klangmodulator/a130-8-expander/README.md

# a130-8-expander
Expander for the Doepfer A130-8 octal linear VCA eurorack module.
Link to Modwiggler thread: [https://modwiggler.com/forum/viewtopic.php?t=268533](https://modwiggler.com/forum/viewtopic.php?t=268533)

## Release 2024-10-12

### Added
- Initial commit PCB v2, revision A
