klangmodulator/a130-8-expander/a130-8-octal-vca-expander-v2.revA.pdf

# 10u ¹²k 12k 18k 30k

# GND -12V

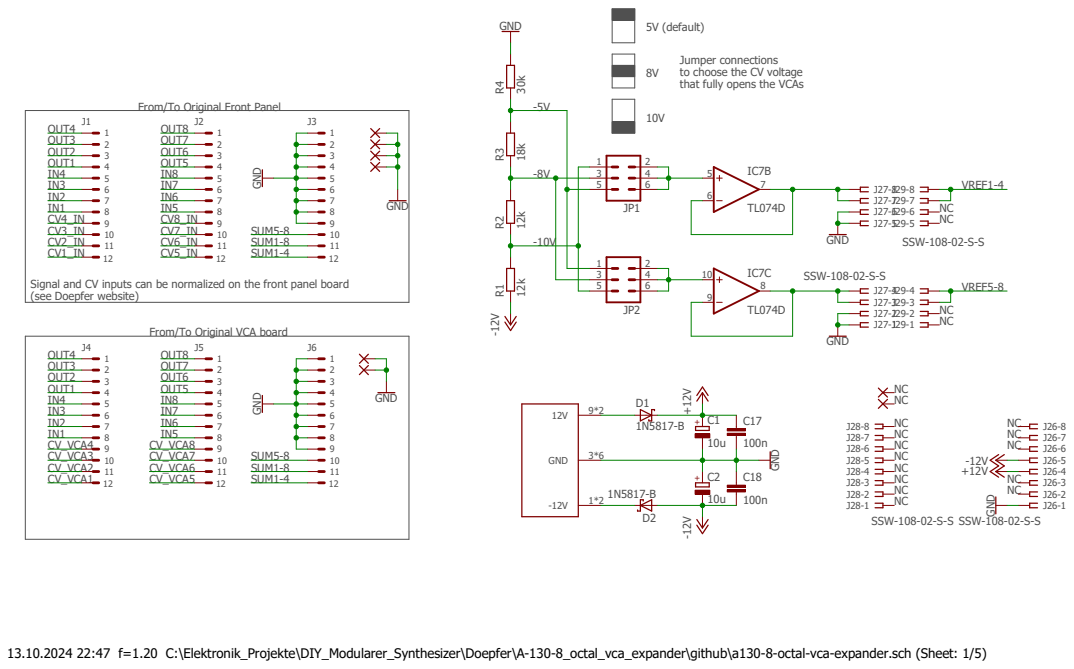
[picture p1: page 1]

Jumper connections
to choose the CV voltage
that fully opens the VCAs

Signal and CV inputs can be normalized on the front panel board
(see Doepfer website)

13.10.2024 22:47 f=1.20 C:\Elektronik_Projekte\DIY_Modularer_Synthesizer\Doepfer\A-130-8_octal_vca_expander\github\a130-8-octal-vca-expander.sch (Sheet: 1/5)

# TL074D B50k_CDET

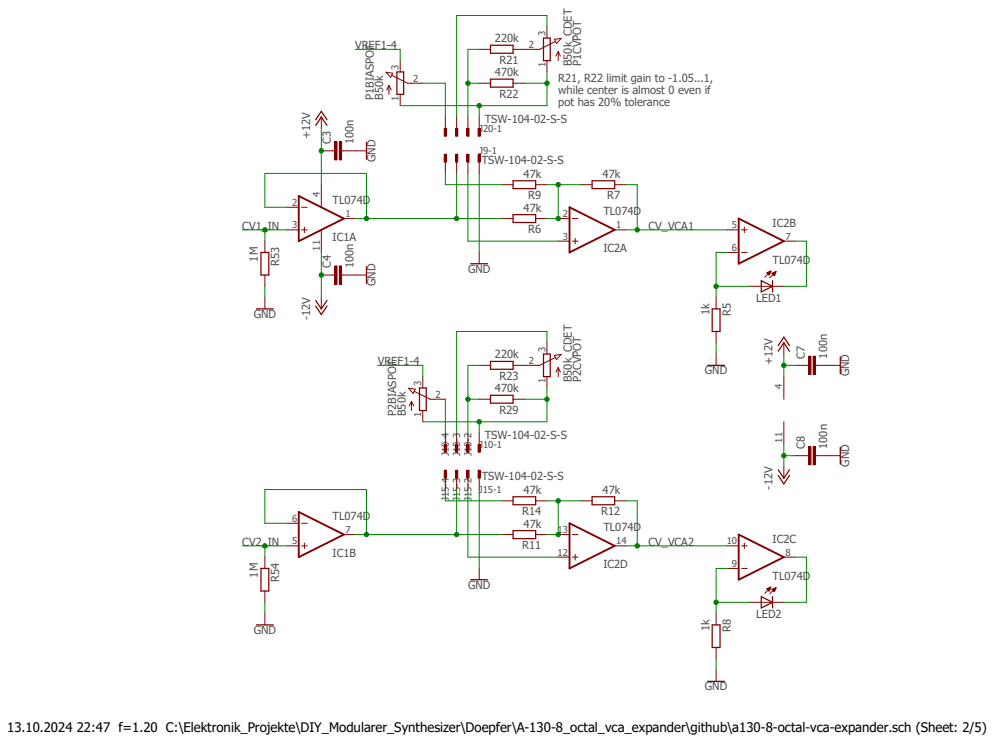
[picture p2: page 2]

R21, R22 limit gain to -1.05...1,
while center is almost 0 even if
pot has 20% tolerance

13.10.2024 22:47 f=1.20 C:\Elektronik_Projekte\DIY_Modularer_Synthesizer\Doepfer\A-130-8_octal_vca_expander\github\a130-8-octal-vca-expander.sch (Sheet: 2/5)

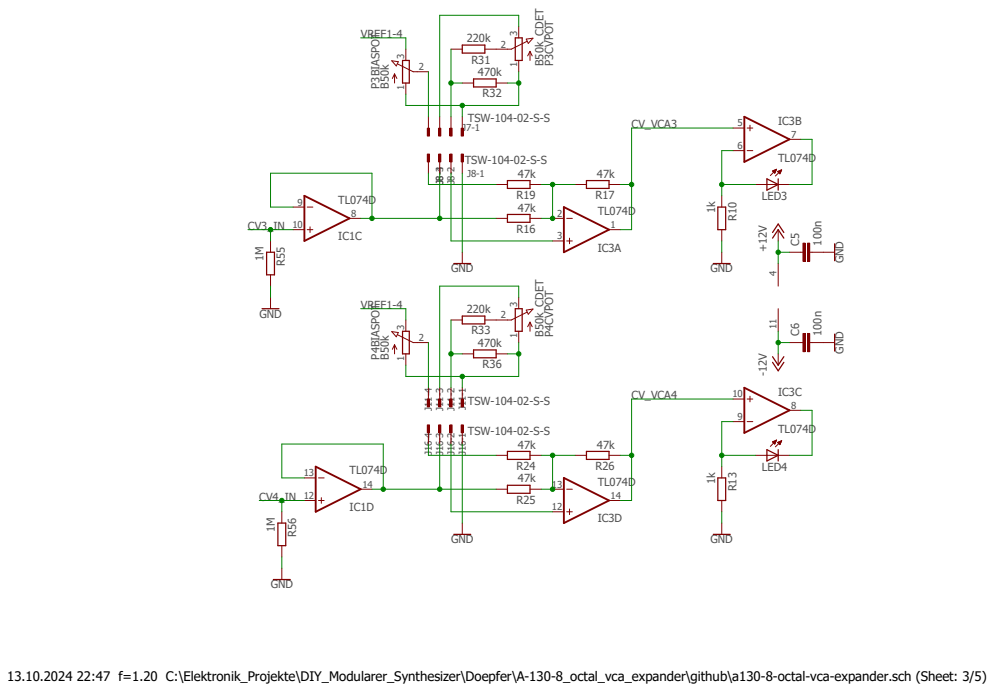
[picture p3: page 3]

13.10.2024 22:47 f=1.20 C:\Elektronik_Projekte\DIY_Modularer_Synthesizer\Doepfer\A-130-8_octal_vca_expander\github\a130-8-octal-vca-expander.sch (Sheet: 3/5)

# TL074D B50k_CDET

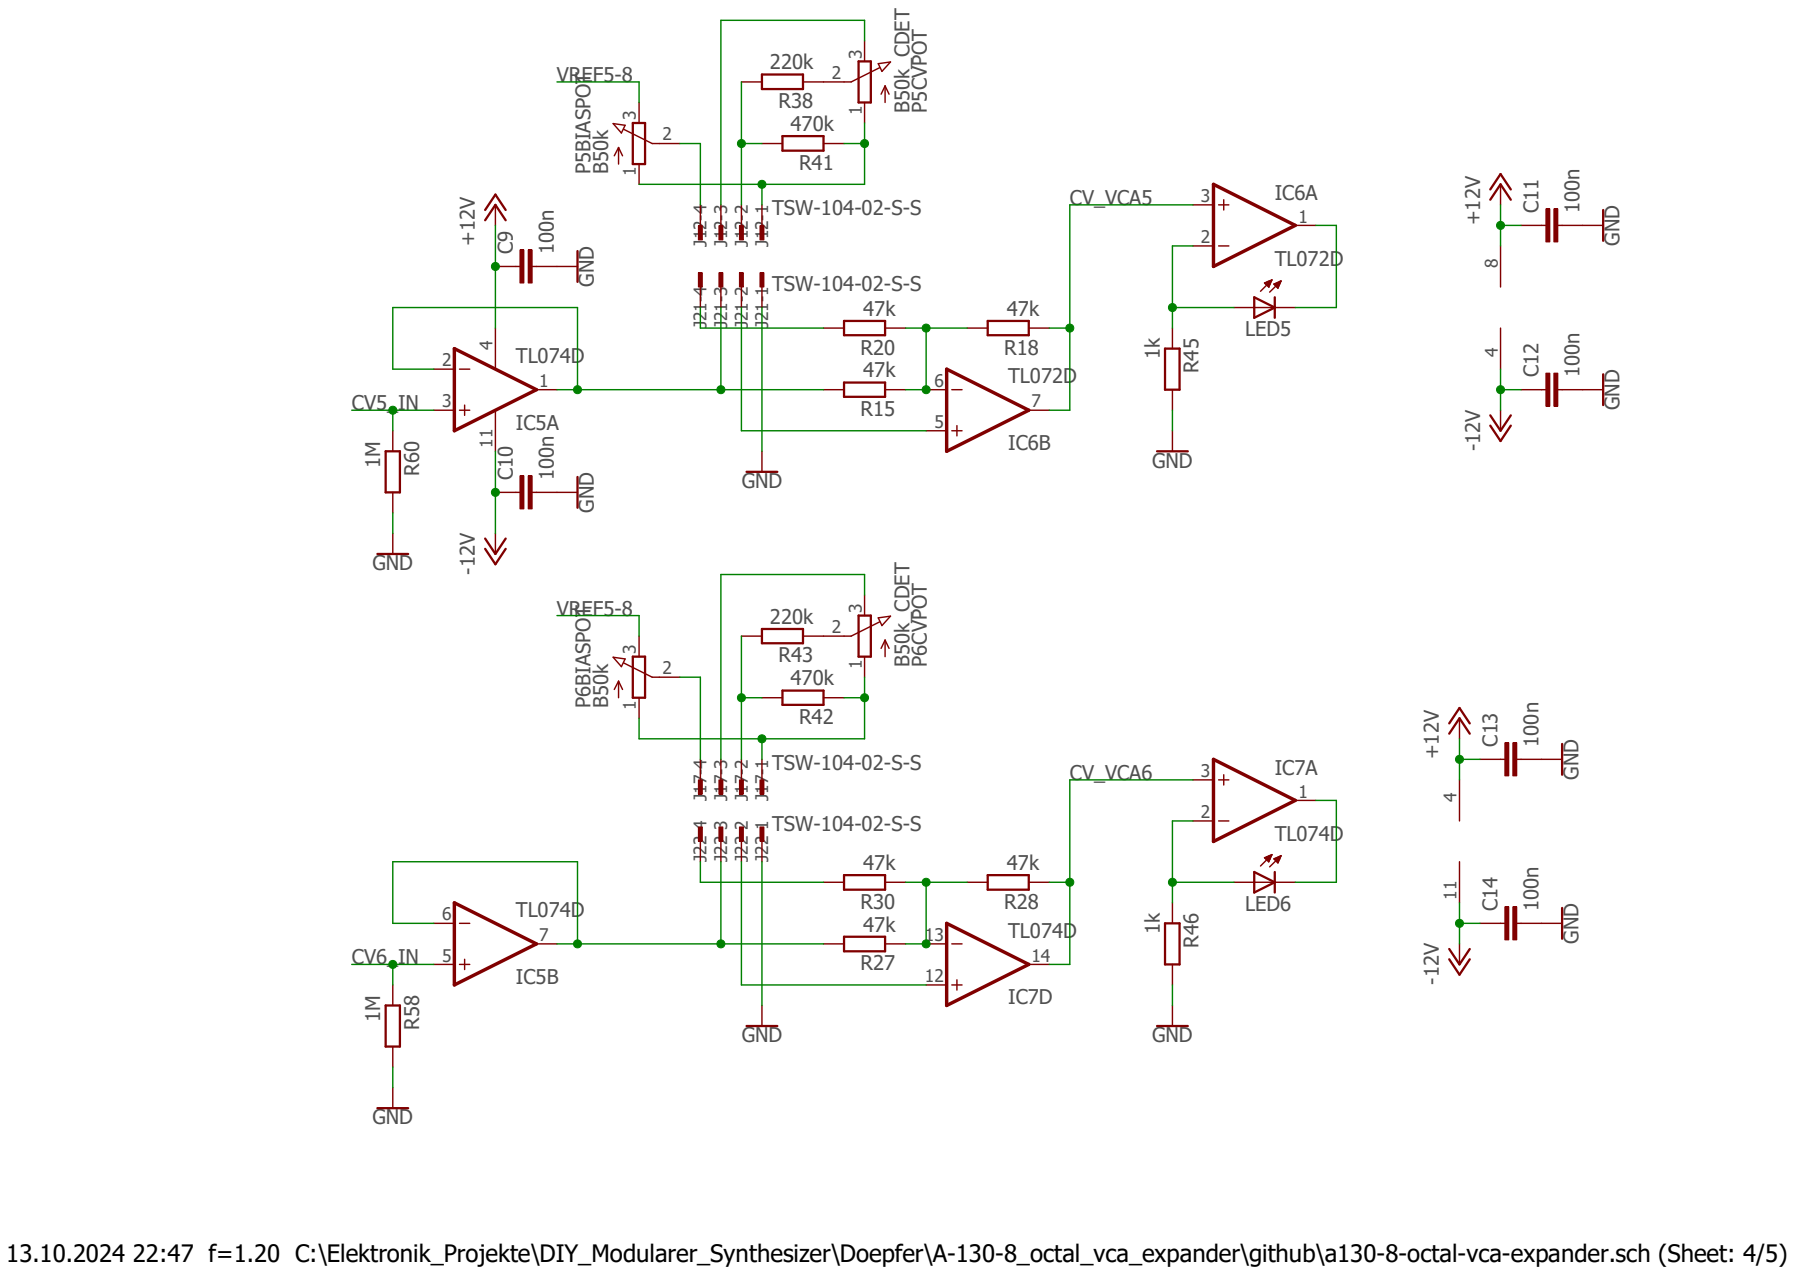
[picture p4: page 4]

13.10.2024 22:47 f=1.20 C:\Elektronik_Projekte\DIY_Modularer_Synthesizer\Doepfer\A-130-8_octal_vca_expander\github\a130-8-octal-vca-expander.sch (Sheet: 4/5)

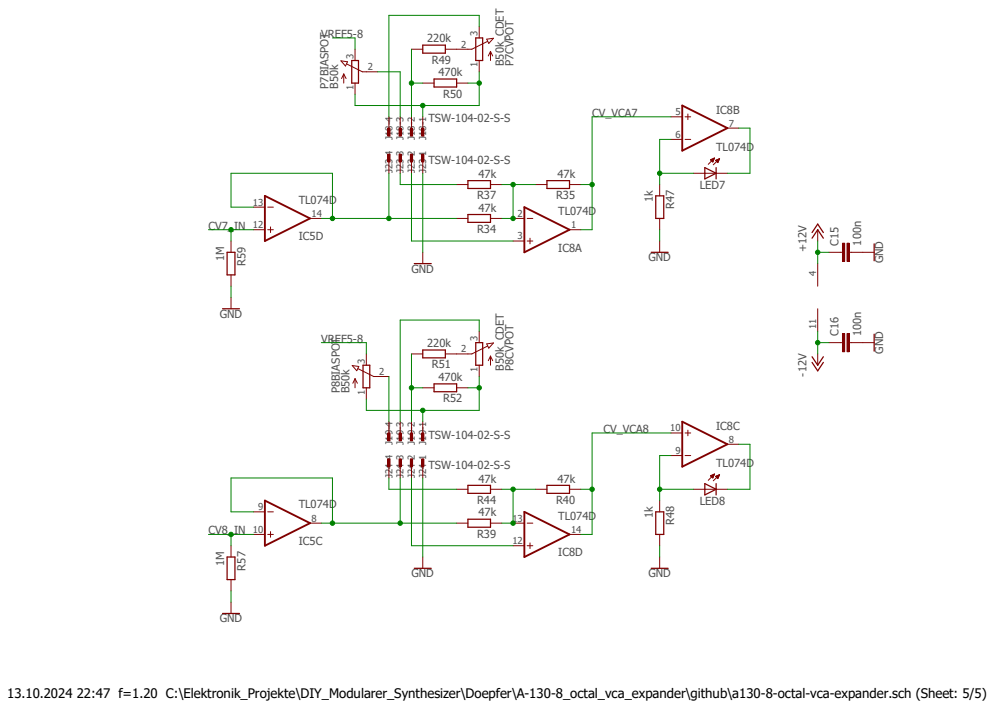
[picture p5: page 5]

13.10.2024 22:47 f=1.20 C:\Elektronik_Projekte\DIY_Modularer_Synthesizer\Doepfer\A-130-8_octal_vca_expander\github\a130-8-octal-vca-expander.sch (Sheet: 5/5)
