klangmodulator/a130-8-expander/a130-8-octal-vca-expander.brd

## EAGLE design a130-8-octal-vca-expander.brd (2024-10-13)

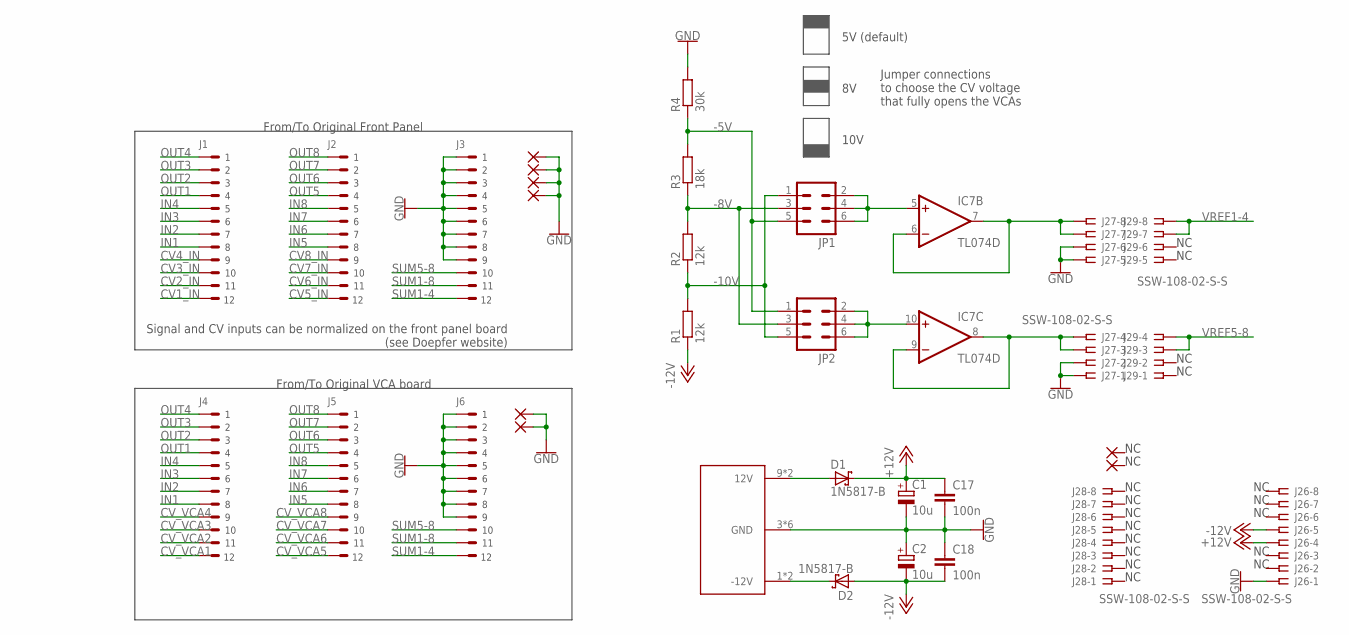
[picture p6: schematic a130-8-octal-vca-expander.sch, sheet 1]

Parts:
C1, C2: 10u; E2-5
C17, C18: 100n; C0603
D1, D2: 1N5817-B; DO41-7.6
IC7: TL074D; SO14
J1, J2, J3, J4, J5, J6: PIN_HEADER_1X12_2MM_GRID
J25: A100-BUS_HEADER_10P; DOEPFER_2X05
J26, J27, J28, J29: SSW-108-02-S-S
JP1, JP2: MA03-2
PAD1, PAD2, PAD3, PAD4, PAD5, PAD6, PAD7, PAD9: 2,15/1,0
R1, R2: 12k; M0805
R3: 18k; M0805
R4: 30k; M0805

Connections:
+12V: C1.+, C17.1, D1.C, J26.4; also elsewhere on the board
-5V: JP1.5, JP2.1, R3.2, R4.1
-8V: JP1.3, JP2.3, R2.2, R3.1
-10V: JP1.1, JP2.5, R1.2, R2.1
-12V: C2.-, C18.2, D2.A, J26.5, R1.1; also elsewhere on the board
CV1_IN: J1.12 (S11); also elsewhere on the board
CV2_IN: J1.11 (S10); also elsewhere on the board
CV3_IN: J1.10 (S9); also elsewhere on the board
CV4_IN: J1.9 (S8); also elsewhere on the board
CV5_IN: J2.12 (S11); also elsewhere on the board
CV6_IN: J2.11 (S10); also elsewhere on the board
CV7_IN: J2.10 (S9); also elsewhere on the board
CV8_IN: J2.9 (S8); also elsewhere on the board
CV_VCA1: J4.12 (S11); also elsewhere on the board
CV_VCA2: J4.11 (S10); also elsewhere on the board
CV_VCA3: J4.10 (S9); also elsewhere on the board
CV_VCA4: J4.9 (S8); also elsewhere on the board
CV_VCA5: J5.12 (S11); also elsewhere on the board
CV_VCA6: J5.11 (S10); also elsewhere on the board
CV_VCA7: J5.10 (S9); also elsewhere on the board
CV_VCA8: J5.9 (S8); also elsewhere on the board
GND: C1.-, C2.+, C17.2, C18.1, J3.1 (S1), J3.2 (S2), J3.3 (S3), J3.4 (S4), J3.5 (S), J3.6 (S5), J3.7 (S6), J3.8 (S7), J3.9 (S8), J6.1 (S1), J6.2 (S2), J6.3 (S3), J6.4 (S4), J6.5 (S), J6.6 (S5), J6.7 (S6), J6.8 (S7), J6.9 (S8), J25.3 (GND), J25.4 (GND), J25.5 (GND), J25.6 (GND), J25.7 (GND), J25.8 (GND), J26.1, J27.1, J27.2, J27.5, J27.6, PAD1.1, PAD2.1, PAD3.1, PAD4.1, PAD5.1, PAD6.1, R4.2; also elsewhere on the board
IN1: J1.8 (S7), J4.8 (S7)
IN2: J1.7 (S6), J4.7 (S6)
IN3: J1.6 (S5), J4.6 (S5)
IN4: J1.4 (S4), J4.4 (S4)
IN5: J2.8 (S7), J5.8 (S7)
IN6: J2.7 (S6), J5.7 (S6)
IN7: J2.6 (S5), J5.6 (S5)
IN8: J2.4 (S4), J5.4 (S4)
unnamed: D1.A, J25.9 (12V), J25.10 (12V)
unnamed: D2.C, J25.1 (-12V), J25.2 (-12V)
unnamed: IC7.5 (+IN), JP1.2, JP1.4, JP1.6
unnamed: IC7.6 (-IN), IC7.7 (OUT), J27.7, J27.8
unnamed: IC7.10 (+IN), JP2.2, JP2.4, JP2.6
unnamed: IC7.8 (OUT), IC7.9 (-IN), J27.3, J27.4
OUT1: J1.3 (S3), J4.3 (S3)
OUT2: J1.2 (S2), J4.2 (S2)
OUT3: J1.1 (S1), J4.1 (S1)
OUT4: J1.5 (S), J4.5 (S)
OUT5: J2.3 (S3), J5.3 (S3)
OUT6: J2.2 (S2), J5.2 (S2)
OUT7: J2.1 (S1), J5.1 (S1)
OUT8: J2.5 (S), J5.5 (S)
SUM1-4: J3.12 (S11), J6.12 (S11)
SUM1-8: J3.11 (S10), J6.11 (S10)
SUM5-8: J3.10 (S9), J6.10 (S9)
VREF1-4: J29.7, J29.8; also elsewhere on the board
VREF5-8: J29.3, J29.4; also elsewhere on the board

Notes on the sheet:
From/To Original Front Panel
Jumper connections to choose the CV voltage that fully opens the VCAs
5V (default)
10V
From/To Original VCA board
Signal and CV inputs can be normalized on the front panel board (see Doepfer website)

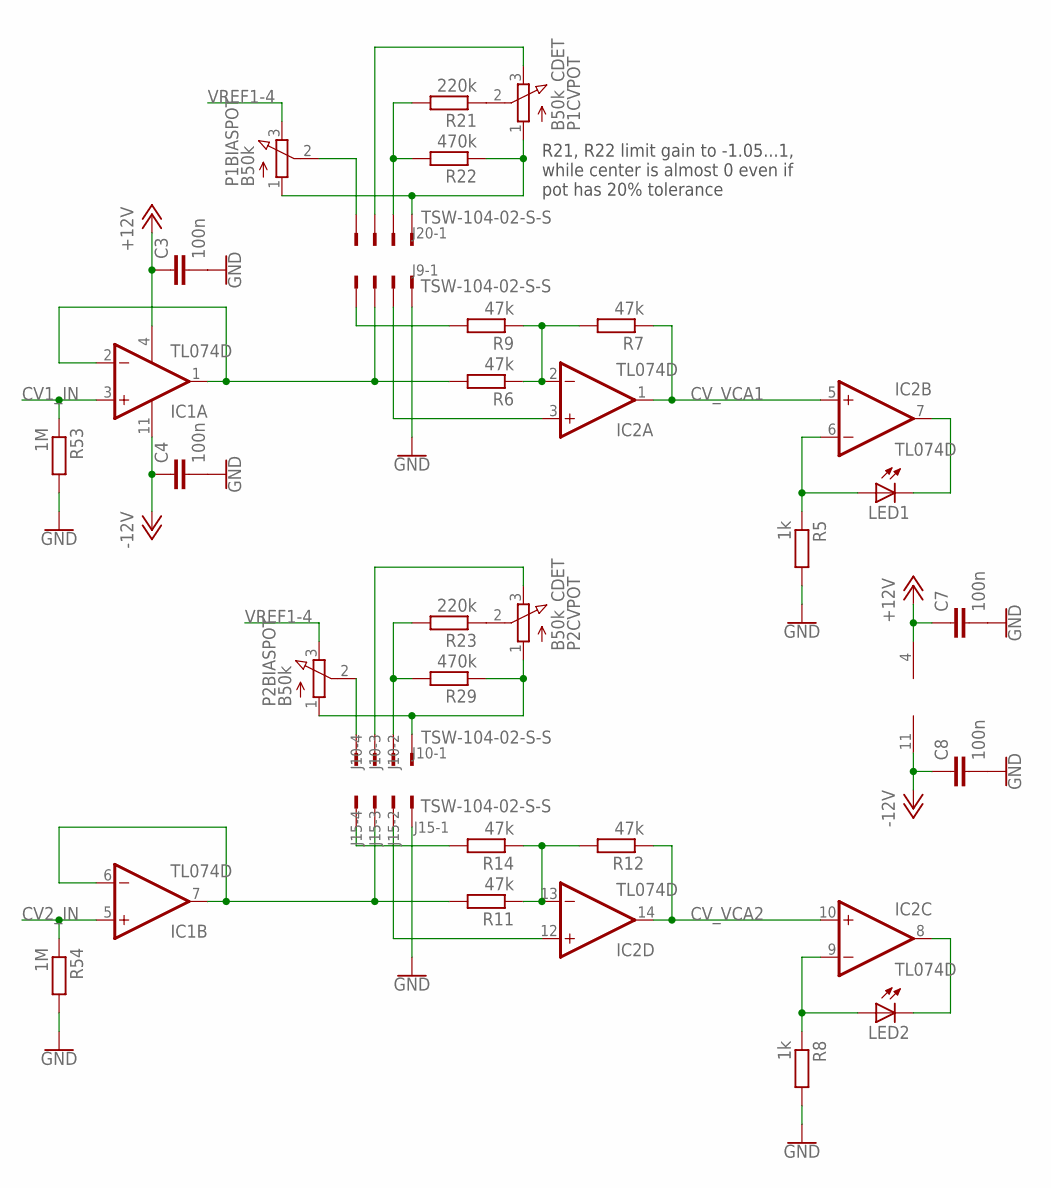
[picture p7: schematic a130-8-octal-vca-expander.sch, sheet 2]

Parts:
C3, C4, C7, C8: 100n; C0603
IC1, IC2, IC3: TL074D; SO14
J9, J10, J15, J20: TSW-104-02-S-S
LED1, LED2: LED3MM
P1BIAS, P2BIAS: B50k; EVUF
P1CV, P2CV: B50k_CDET; EVUF
R5, R8: 1k; M0805
R6, R7, R9, R11, R12, R14: 47k; M0805
R21, R23: 220k; M0805
R22, R29: 470k; M0805
R53, R54: 1M; M0805

Connections:
+12V: C3.1, C7.1, IC1.4 (V+), IC3.4 (V+); also elsewhere on the board
-12V: C4.1, C8.1, IC1.11 (V-), IC3.11 (V-); also elsewhere on the board
CV1_IN: IC1.3 (+IN), R53.1; also elsewhere on the board
CV2_IN: IC1.5 (+IN), R54.1; also elsewhere on the board
CV_VCA1: IC2.1 (OUT), IC2.5 (+IN), R7.1; also elsewhere on the board
CV_VCA2: IC2.10 (+IN), IC2.14 (OUT), R12.1; also elsewhere on the board
GND: C3.2, C4.2, C7.2, C8.2, J15.1, J20.1, R5.2, R8.2, R53.2, R54.2; also elsewhere on the board
unnamed: J9.4, P1BIAS.2
unnamed: IC1.1 (OUT), IC1.2 (-IN), J20.3, R6.2
unnamed: IC2.2 (-IN), R6.1, R7.2, R9.1
unnamed: J20.4, R9.2
unnamed: IC1.6 (-IN), IC1.7 (OUT), J15.3, R11.2
unnamed: IC2.12 (+IN), J15.2
unnamed: IC2.13 (-IN), R11.1, R12.2, R14.1
unnamed: J9.1, P1BIAS.1, P1CV.1, R22.1
unnamed: IC2.6 (-IN), LED1.A, R5.1
unnamed: IC2.7 (OUT), LED1.K (C)
unnamed: IC2.8 (OUT), LED2.K (C)
unnamed: IC2.9 (-IN), LED2.A, R8.1
unnamed: J15.4, R14.2
unnamed: P2CV.2, R23.1
unnamed: J9.3, P1CV.3
unnamed: IC2.3 (+IN), J20.2
unnamed: J10.1, P2BIAS.1, P2CV.1, R29.1
unnamed: J10.2, R23.2, R29.2
unnamed: J10.3, P2CV.3
unnamed: J10.4, P2BIAS.2
unnamed: P1CV.2, R21.1
unnamed: J9.2, R21.2, R22.2
VREF1-4: P1BIAS.3, P2BIAS.3; also elsewhere on the board

Notes on the sheet:
R21, R22 limit gain to -1.05...1, while center is almost 0 even if pot has 20% tolerance

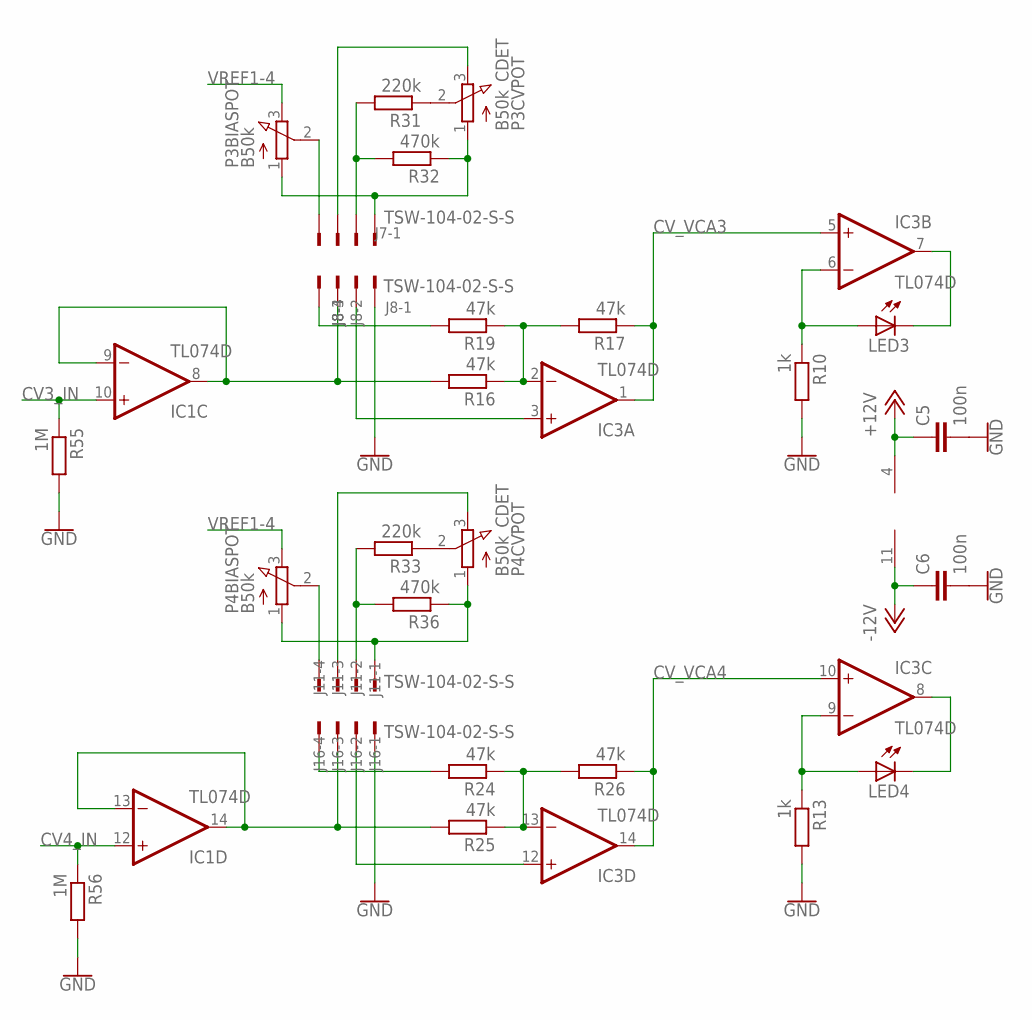
[picture p8: schematic a130-8-octal-vca-expander.sch, sheet 3]

Parts:
C5, C6: 100n; C0603
IC1, IC2, IC3: TL074D; SO14
J7, J8, J11, J16: TSW-104-02-S-S
LED3, LED4: LED3MM
P3BIAS, P4BIAS: B50k; EVUF
P3CV, P4CV: B50k_CDET; EVUF
R10, R13: 1k; M0805
R16, R17, R19, R24, R25, R26: 47k; M0805
R31, R33: 220k; M0805
R32, R36: 470k; M0805
R55, R56: 1M; M0805

Connections:
+12V: C5.1, IC2.4 (V+); also elsewhere on the board
-12V: C6.1, IC2.11 (V-); also elsewhere on the board
CV3_IN: IC1.10 (+IN), R55.1; also elsewhere on the board
CV4_IN: IC1.12 (+IN), R56.1; also elsewhere on the board
CV_VCA3: IC3.1 (OUT), IC3.5 (+IN), R17.1; also elsewhere on the board
CV_VCA4: IC3.10 (+IN), IC3.14 (OUT), R26.1; also elsewhere on the board
GND: C5.2, C6.2, J8.1, J16.1, R10.2, R13.2, R55.2, R56.2; also elsewhere on the board
unnamed: IC1.8 (OUT), IC1.9 (-IN), J8.3, R16.2
unnamed: J7.4, P3BIAS.2
unnamed: IC3.2 (-IN), R16.1, R17.2, R19.1
unnamed: J8.4, R19.2
unnamed: IC1.13 (-IN), IC1.14 (OUT), J16.3, R25.2
unnamed: J16.4, R24.2
unnamed: IC3.13 (-IN), R24.1, R25.1, R26.2
unnamed: IC3.12 (+IN), J16.2
unnamed: IC3.6 (-IN), LED3.A, R10.1
unnamed: IC3.7 (OUT), LED3.K (C)
unnamed: IC3.9 (-IN), LED4.A, R13.1
unnamed: IC3.8 (OUT), LED4.K (C)
unnamed: J7.1, P3BIAS.1, P3CV.1, R32.1
unnamed: J7.2, R31.2, R32.2
unnamed: J7.3, P3CV.3
unnamed: IC3.3 (+IN), J8.2
unnamed: J11.1, P4BIAS.1, P4CV.1, R36.1
unnamed: J11.4, P4BIAS.2
unnamed: J11.3, P4CV.3
unnamed: J11.2, R33.2, R36.2
unnamed: P3CV.2, R31.1
unnamed: P4CV.2, R33.1
VREF1-4: P3BIAS.3, P4BIAS.3; also elsewhere on the board

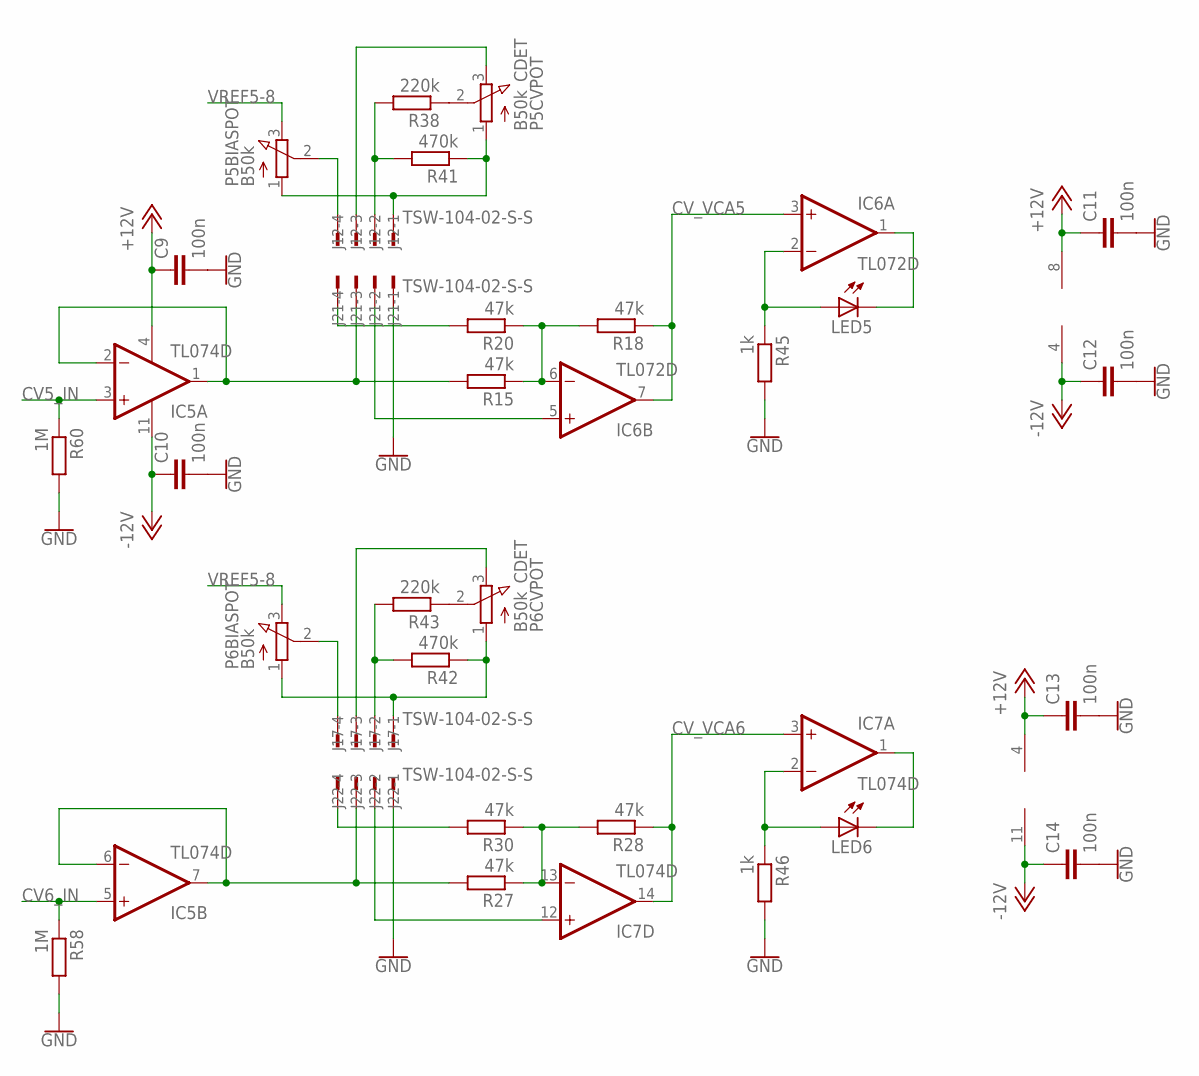
[picture p9: schematic a130-8-octal-vca-expander.sch, sheet 4]

Parts:
C9, C10, C11, C12, C13, C14: 100n; C0603
IC5, IC7: TL074D; SO14
IC6: TL072D; SO08
J12, J17, J21, J22: TSW-104-02-S-S
LED5, LED6: LED3MM
P5BIAS, P6BIAS: B50k; EVUF
P5CV, P6CV: B50k_CDET; EVUF
R15, R18, R20, R27, R28, R30: 47k; M0805
R38, R43: 220k; M0805
R41, R42: 470k; M0805
R45, R46: 1k; M0805
R58, R60: 1M; M0805

Connections:
+12V: C9.1, C11.1, C13.1, IC5.4 (V+), IC6.8 (V+), IC7.4 (V+); also elsewhere on the board
-12V: C10.1, C12.1, C14.1, IC5.11 (V-), IC6.4 (V-), IC7.11 (V-); also elsewhere on the board
CV5_IN: IC5.3 (+IN), R60.1; also elsewhere on the board
CV6_IN: IC5.5 (+IN), R58.1; also elsewhere on the board
CV_VCA5: IC6.3 (+IN), IC6.7 (OUT), R18.1; also elsewhere on the board
CV_VCA6: IC7.3 (+IN), IC7.14 (OUT), R28.1; also elsewhere on the board
GND: C9.2, C10.2, C11.2, C12.2, C13.2, C14.2, J21.1, J22.1, R45.2, R46.2, R58.2, R60.2; also elsewhere on the board
unnamed: J17.4, P6BIAS.2
unnamed: IC5.1 (OUT), IC5.2 (-IN), J21.3, R15.2
unnamed: J12.2, R38.2, R41.2
unnamed: IC6.6 (-IN), R15.1, R18.2, R20.1
unnamed: J12.1, P5BIAS.1, P5CV.1, R41.1
unnamed: IC5.6 (-IN), IC5.7 (OUT), J22.3, R27.2
unnamed: J17.1, P6BIAS.1, P6CV.1, R42.1
unnamed: IC7.13 (-IN), R27.1, R28.2, R30.1
unnamed: J22.4, R30.2
unnamed: IC6.2 (-IN), LED5.A, R45.1
unnamed: IC6.1 (OUT), LED5.K (C)
unnamed: IC7.1 (OUT), LED6.K (C)
unnamed: IC7.2 (-IN), LED6.A, R46.1
unnamed: J17.2, R42.2, R43.2
unnamed: J12.3, P5CV.3
unnamed: J12.4, P5BIAS.2
unnamed: IC6.5 (+IN), J21.2
unnamed: J21.4, R20.2
unnamed: J17.3, P6CV.3
unnamed: IC7.12 (+IN), J22.2
unnamed: P5CV.2, R38.1
unnamed: P6CV.2, R43.1
VREF5-8: P5BIAS.3, P6BIAS.3; also elsewhere on the board

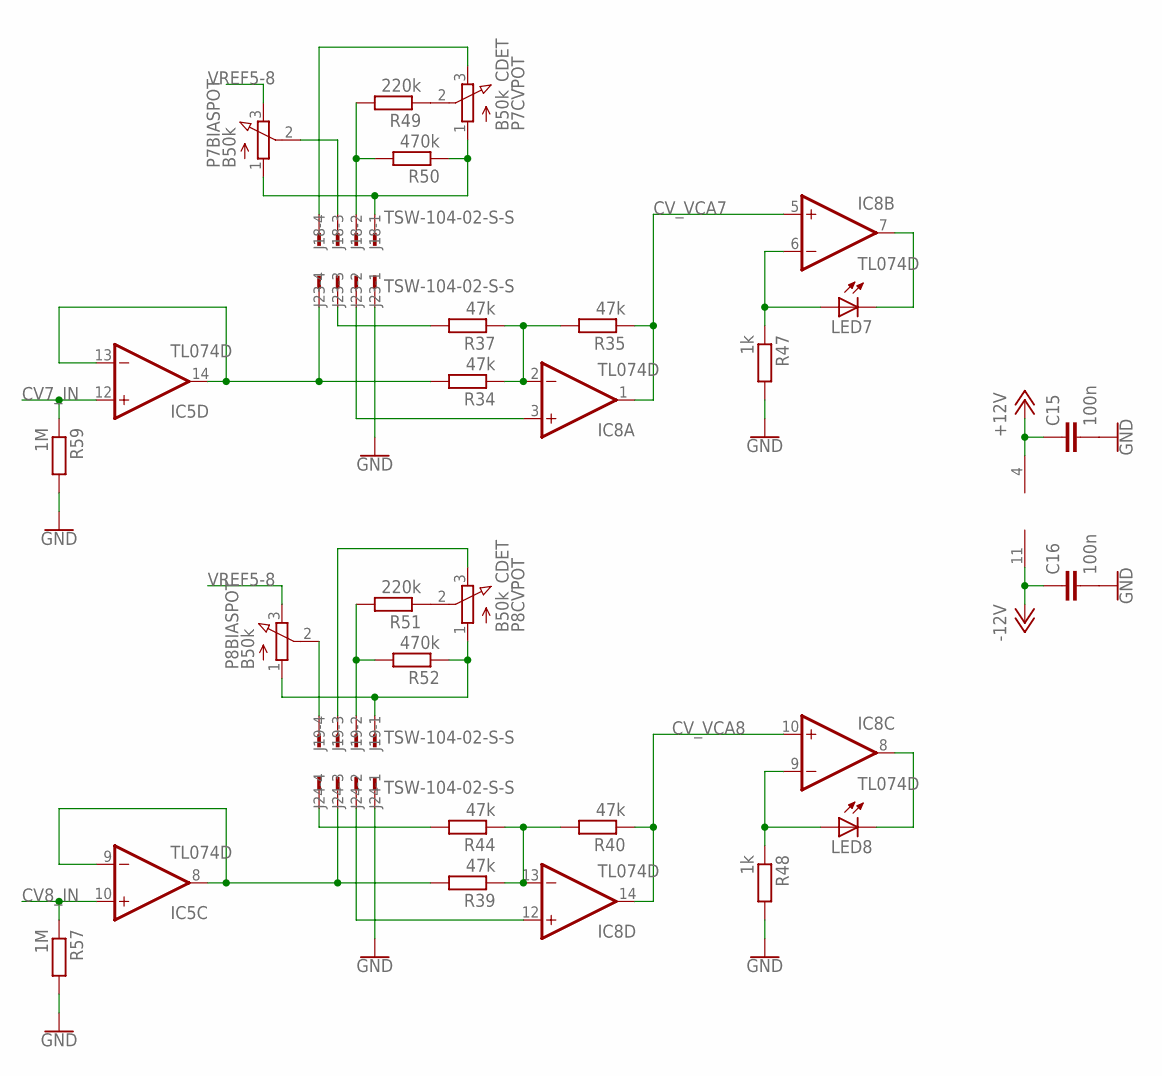
[picture p10: schematic a130-8-octal-vca-expander.sch, sheet 5]

Parts:
C15, C16: 100n; C0603
IC5, IC8: TL074D; SO14
J18, J19, J23, J24: TSW-104-02-S-S
LED7, LED8: LED3MM
P7BIAS, P8BIAS: B50k; EVUF
P7CV, P8CV: B50k_CDET; EVUF
R34, R35, R37, R39, R40, R44: 47k; M0805
R47, R48: 1k; M0805
R49, R51: 220k; M0805
R50, R52: 470k; M0805
R57, R59: 1M; M0805

Connections:
+12V: C15.1, IC8.4 (V+); also elsewhere on the board
-12V: C16.1, IC8.11 (V-); also elsewhere on the board
CV7_IN: IC5.12 (+IN), R59.1; also elsewhere on the board
CV8_IN: IC5.10 (+IN), R57.1; also elsewhere on the board
CV_VCA7: IC8.1 (OUT), IC8.5 (+IN), R35.1; also elsewhere on the board
CV_VCA8: IC8.10 (+IN), IC8.14 (OUT), R40.1; also elsewhere on the board
GND: C15.2, C16.2, J23.1, J24.1, R47.2, R48.2, R57.2, R59.2; also elsewhere on the board
unnamed: J23.3, R37.2
unnamed: J18.4, P7CV.3
unnamed: IC8.2 (-IN), R34.1, R35.2, R37.1
unnamed: J18.2, R49.2, R50.2
unnamed: IC5.8 (OUT), IC5.9 (-IN), J24.3, R39.2
unnamed: J19.1, P8BIAS.1, P8CV.1, R52.1
unnamed: IC8.13 (-IN), R39.1, R40.2, R44.1
unnamed: IC8.12 (+IN), J24.2
unnamed: IC8.6 (-IN), LED7.A, R47.1
unnamed: IC8.7 (OUT), LED7.K (C)
unnamed: IC8.9 (-IN), LED8.A, R48.1
unnamed: IC8.8 (OUT), LED8.K (C)
unnamed: P7CV.2, R49.1
unnamed: J18.1, P7BIAS.1, P7CV.1, R50.1
unnamed: IC5.13 (-IN), IC5.14 (OUT), J23.4, R34.2
unnamed: J18.3, P7BIAS.2
unnamed: J19.3, P8CV.3
unnamed: IC8.3 (+IN), J23.2
unnamed: J19.4, P8BIAS.2
unnamed: J24.4, R44.2
unnamed: P8CV.2, R51.1
unnamed: J19.2, R51.2, R52.2
VREF5-8: P7BIAS.3, P8BIAS.3; also elsewhere on the board

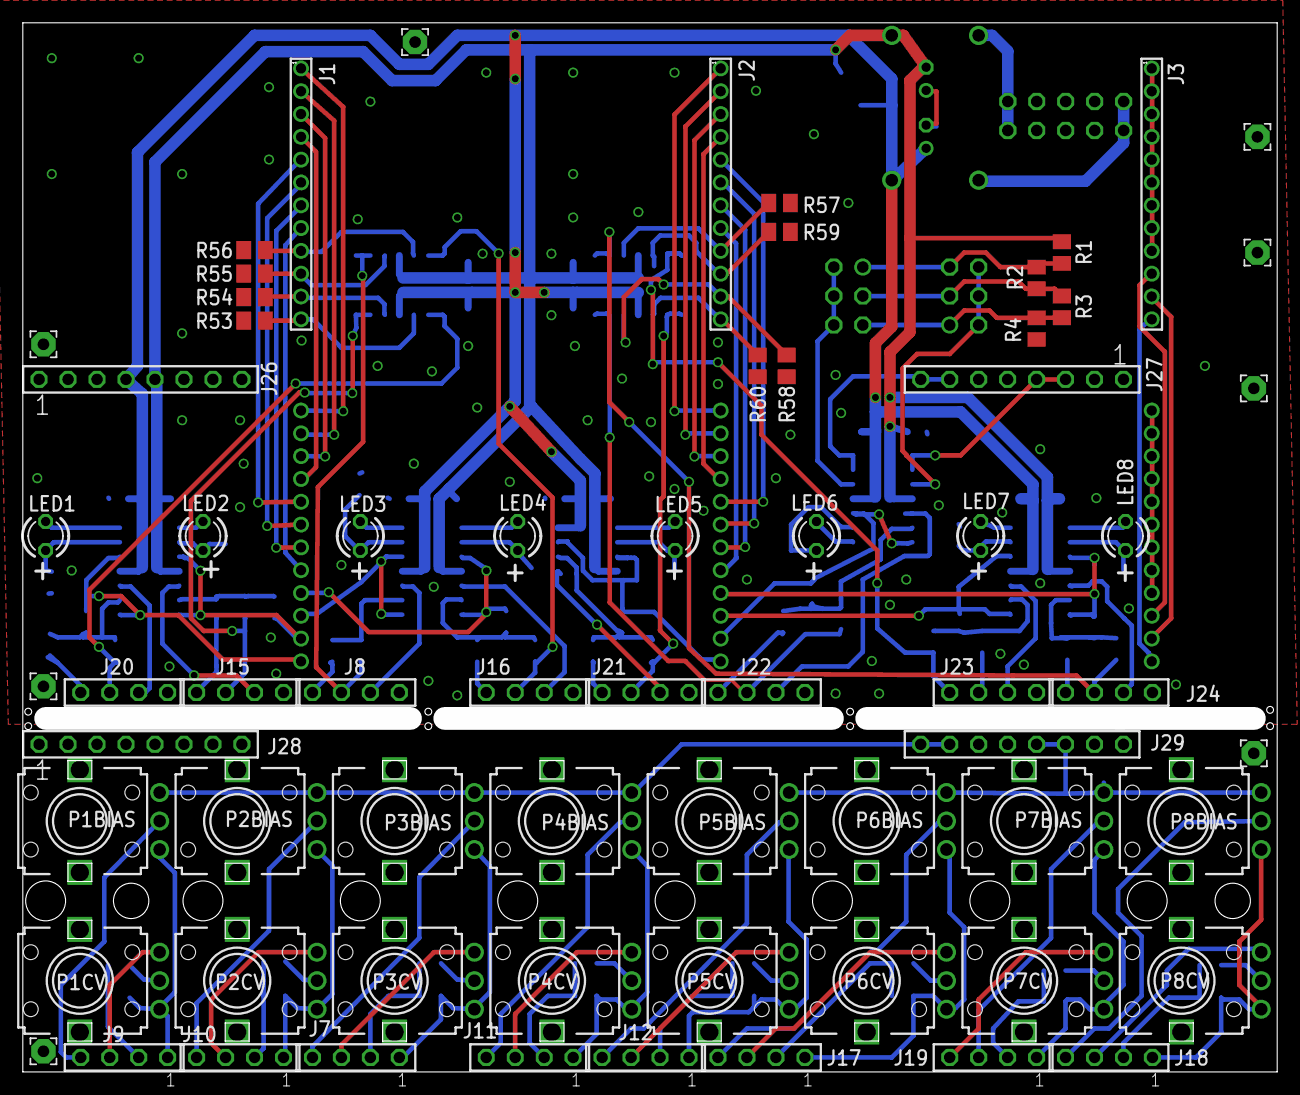
[picture p11: board a130-8-octal-vca-expander.brd from above]

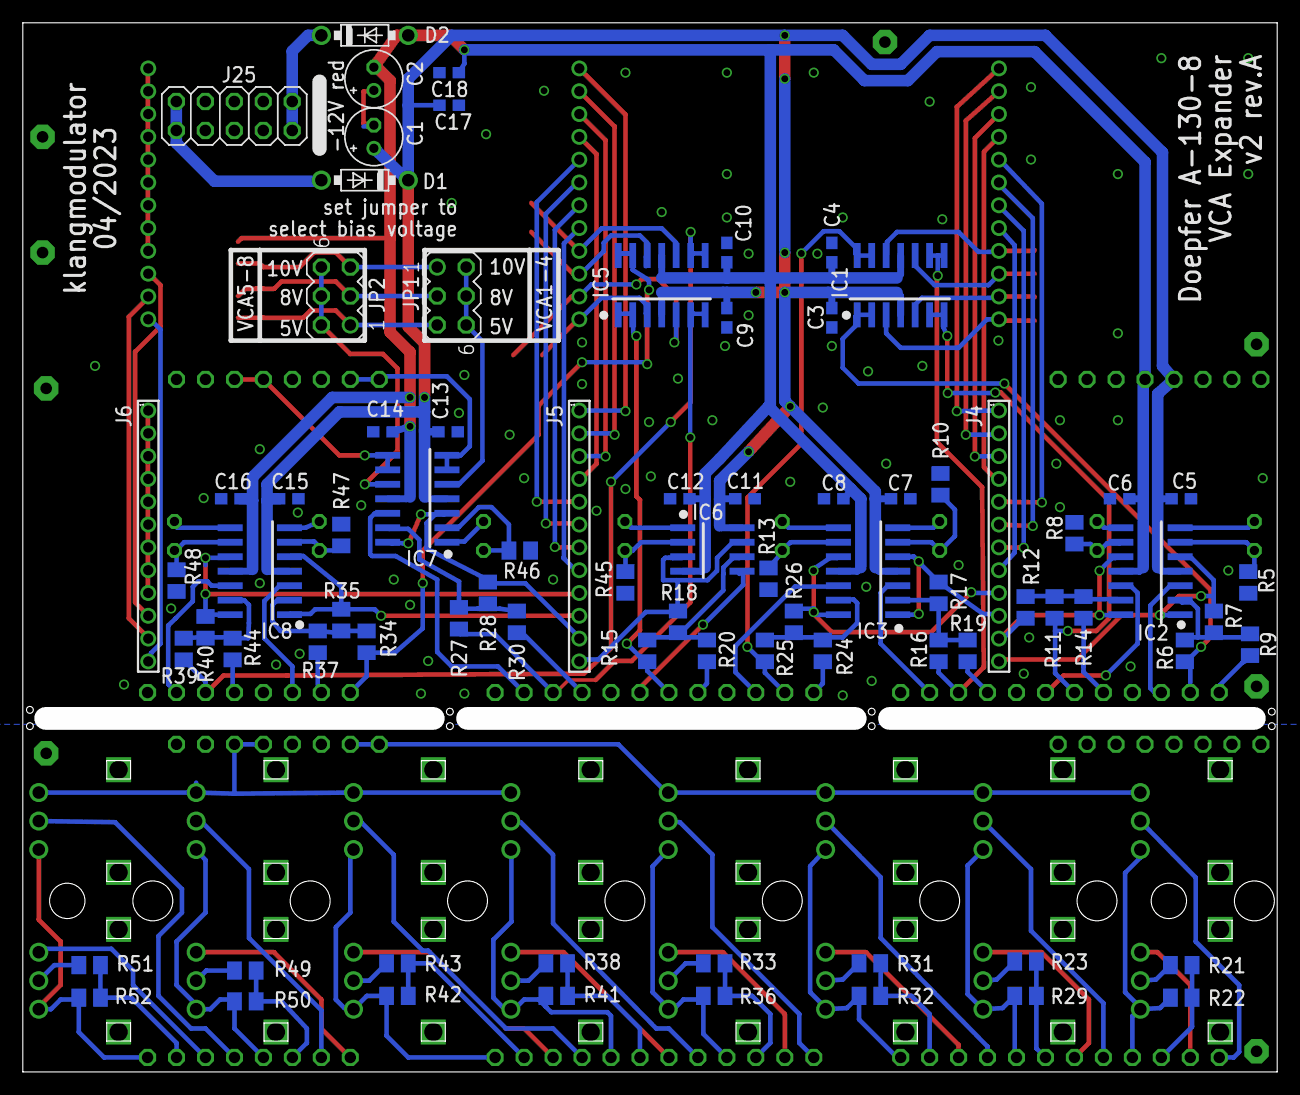
[picture p12: board a130-8-octal-vca-expander.brd from below]

Board: 2 copper layers, 110.0 x 92.0 mm, 148 parts (81 on the bottom side), 137 nets.
