klangmodulator/a130-8-expander/(commit log)

2024-10-13 Initial commit version v2 revision A
    [BOM a130-8-octal-vca-expander-v2.revA.csv, a130-8-octal-vca-expander.brd, a130-8-octal-vca-expander.sch]
2024-10-13 Added link to modwiggler thread to readme
2024-10-13 Fixed missing trace on net N$58
    [a130-8-octal-vca-expander.brd]
